maland16/bus-departure-board/README.md

# GPMetro Bus Stop Departure Board

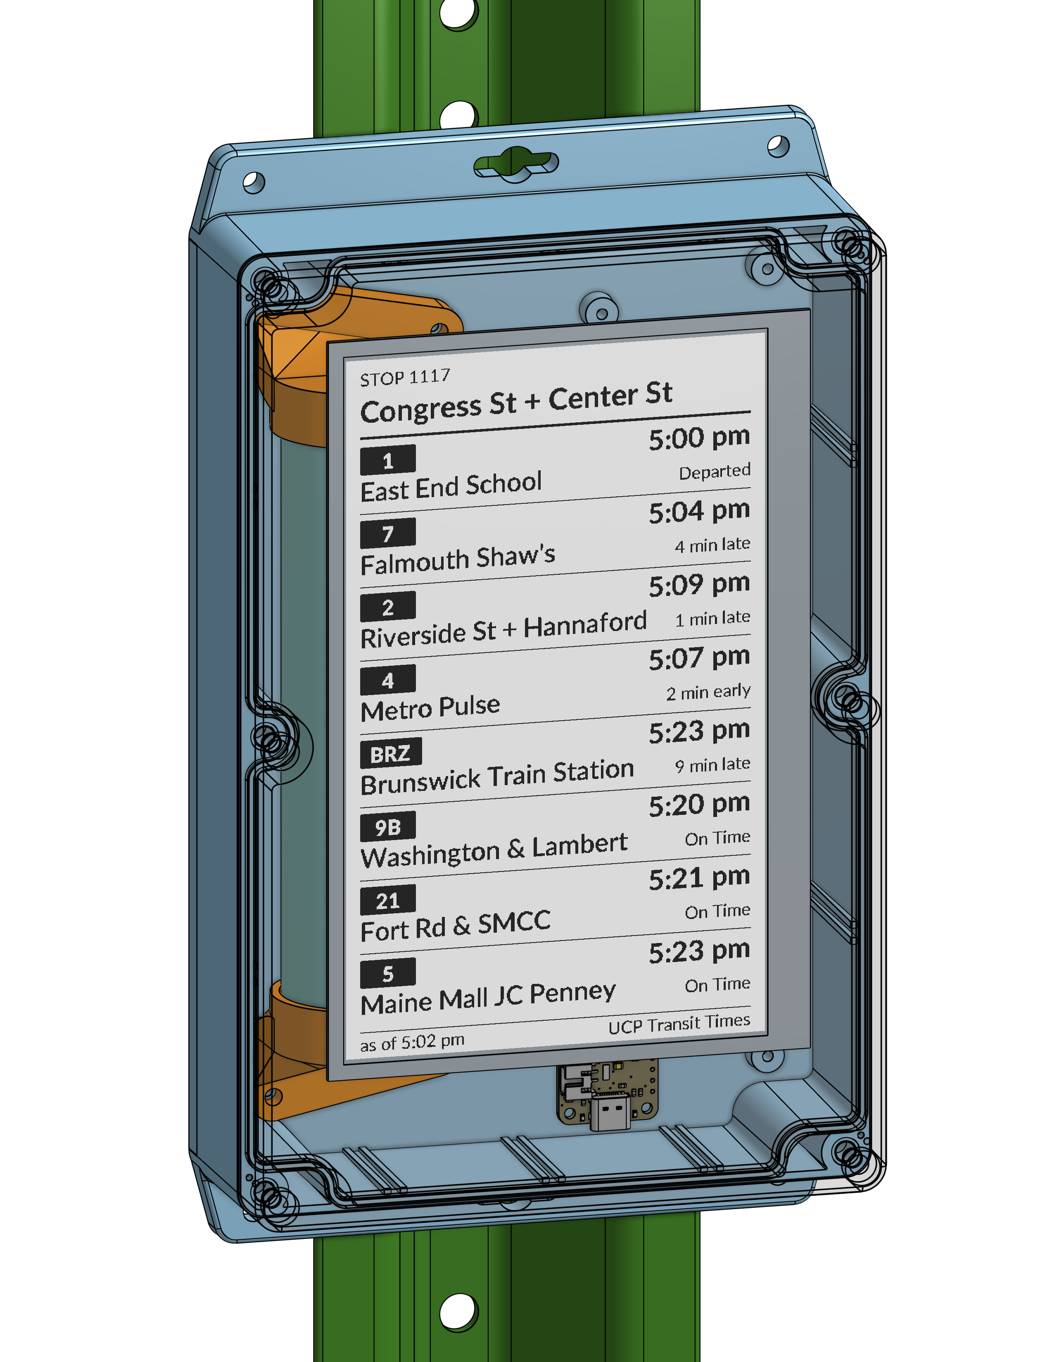
[picture p1: docs/Assembly 1.png]
Prototype departure board design

The goal of this project is to create a relatively low cost standalone live departure board for Portland Metro bus stops. This design uses an ESP32, e-ink display, and large LiFePo4 cell recharged via solar.

```mermaid
graph TD;

    A[GPMetro GTFS Feed] --> B["UCOP transit server parses GTFS and makes pretty image"];
    
    B -->|Bitmap image of recent & upcoming departures|C[ESP-32 Based display at bus stop];

    D["InfluxDB viewable via Grafana"] ---|"Telemetry Data (Batt/Solar voltage, temp, status, etc.)"|C;
```

## Electrical Topology

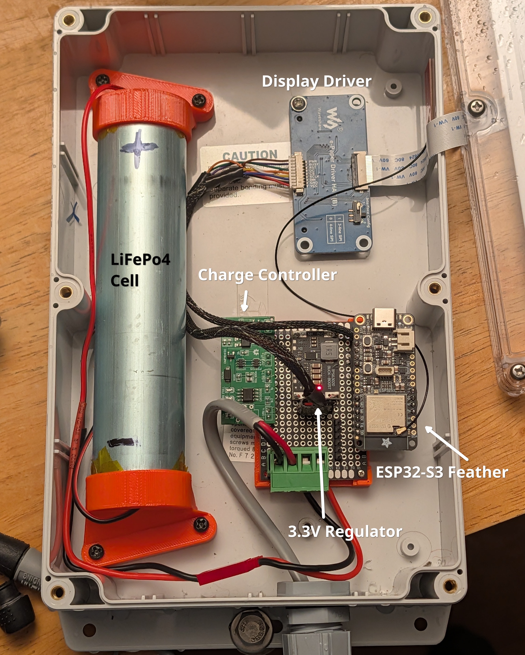
[picture p2: docs/V1-internals.jpg]
Internals


### [Read more here](docs/electricalTopology.md)

## Display

A Good Display GDEM075T41WT: a 7.5", 800x480 black/white e-paper panel rated for -25°C to 50°C. Specs, firmware notes and wiring are in [docs/display.md](docs/display.md).

## Physical Layer Options
- Wifi via ESP32 hardware [ Selected for version 1 ]
    - Advantages: Built into the ESP32 hardware, easy to setup and well supported
    - Disadvantages: Wifi is not hugely reliable outdoors, and relying on random public networks as a part of infrastructure isn't great
- LoRa via external hardware
    - Advantages: LoRa has far better range and probably better reliability, and there's only one bridge to the internet instead of one on each ESP32. This solution might also be more scalable, though I'm not super familir with the scalability of LoRa used for this purpose
    - Disadvantages: Requires working around bandwith limitations (no photos sent to displays), and requires a gateway to bridge LoRa -> HTTPS. Also requires getting and using specialized LoRa hardware
- Cellular
    - Advantages: Reliability, range, throughput (can still do bitmaps). This is what the commercially available products use.
    - Disadvantages: Cost (hardware, subscription), power consumption.
- A secret fourth thing??

### Arduino/ESP32 Libraries
**GxEPD2** - E-Ink display driver  
**WifiClientSecure** - For HTTPS  
**ESP32Time**

### Improvements for rev 2:
- Use backplane bracket inside the waterproof case so servicing is easier
    - Attach display to backplane instead of the front of the case
    - Attach all other bits to the backplane so it can be swapped out easily if needed
- Cellular connectivity
- Use [powerfeather ESP32](https://powerfeather.dev/)
- OTA updates, versioning
