maland16/bus-departure-board/docs/bom.md

| Part | Description | Link |
| --- | --- | - |
| ESP-32 | Adafruit ESP32-S3 Feather 8MB with w.FL Antenna (for better wifi reception) | [Adafruit store](https://www.adafruit.com/product/5885) |
| E-ink display | Good Display GDEM075T41WT, 7.5" 800x480 black/white, wide temperature (-25°C to 50°C), UC8179. See [display.md](display.md) | [Good Display](https://www.good-display.com/product/700.html) |
| Antenna | Text |  |
| Charge controller | Text |  |
| Enclosure | Text |  |
| Battery | Text |  |
| Solar panel | Text |  |
