maland16/bus-departure-board/src/departure-board/display-driver.cpp

#include "display-driver.h"

#include "GxEPD2_display_selection_new_style.h"

#include <WiFiClientSecure.h>
#include <HTTPClient.h>
#include <ESP32Time.h>
#include <esp_rom_crc.h>

#include <Fonts/FreeMonoBold9pt7b.h>
#include <Fonts/FreeMonoBold12pt7b.h>
#include <Fonts/FreeSans18pt7b.h>
#include <Fonts/FreeSansBold24pt7b.h>
#include <Fonts/FreeSans12pt7b.h>

#include "src/third-party/QRCode/src/rm_qrcode.h"

#include "wifi-driver.h"
#include "rtc-driver.h"
#include "wake-stats.h"

#define BITMAP_SIGNATURE (0x4D42) // "BM" in hex
#define MAX_EXPECTED_HEADER_POSITION_BYTES (50)
#define FETCH_IMAGE_TIMEOUT_MS (20000)
#define FETCH_IMAGE_TIMEOUT_EXPIRED(X) (millis() - X > FETCH_IMAGE_TIMEOUT_MS)
#define HTTP_GET_RETRIES (3)

HTTPClient http;

// ---- Fixed target dimensions (native GxEPD2_750_T7 resolution) ----
static const uint16_t PANEL_WIDTH  = 800;
static const uint16_t PANEL_HEIGHT = 480;

static const size_t FRAMEBUFFER_ROW_BYTES = (PANEL_WIDTH + 7) / 8;                 // 100
static const size_t FRAMEBUFFER_SIZE      = FRAMEBUFFER_ROW_BYTES * PANEL_HEIGHT;  // 48000

// Worst case row size across supported bit depths (24bpp is the largest per row)
static const size_t MAX_BMP_ROW_BYTES = ((uint32_t)PANEL_WIDTH * 24 + 31) / 32 * 4; // 2400

// ---- Static buffers, reused across calls ----
static uint8_t framebuffer[FRAMEBUFFER_SIZE];
static uint8_t bmpRowBuf[MAX_BMP_ROW_BYTES];
static bool blackTable[256]; // palette-index -> "is this black?" lookup for 1/8bpp BMPs

// CRC32 of the image currently on the panel, saved across deep sleep so we can
// skip refreshing when the downloaded image hasn't changed. Cleared whenever
// something else is drawn over the live image.
RTC_DATA_ATTR static uint32_t lastFramebufferCrc = 0;
RTC_DATA_ATTR static bool lastFramebufferCrcValid = false;

void initDisplayDriver()
{
    display.init(115200, true, 2, false); // Initialize display

    // don't keep the TCP/TLS connection alive between calls - a reused
    // connection that's gone stale (idle timeout, NAT/firewall drop) can
    // hang indefinitely on write with no error and no timeout, since that
    // happens below the level http.setTimeout() covers
    http.setReuse(false);
    http.setFollowRedirects(HTTPC_STRICT_FOLLOW_REDIRECTS); // in case the file is served via a CDN/redirect
    http.setTimeout(8000);
    Serial.println("Display initialized");
}

// ---- Blocking read of exactly `len` bytes from any Stream, with a stall timeout ----
static bool readFully(Stream &s, uint8_t *dst, size_t len, uint32_t timeoutMs = 8000) {
  size_t got = 0;
  uint32_t lastProgress = millis();
  while (got < len) {
    int avail = s.available();
    if (avail > 0) {
      int n = s.readBytes(dst + got, len - got);
      if (n > 0) {
        got += n;
        lastProgress = millis();
        continue;
      }
    }
    if (millis() - lastProgress > timeoutMs) return false; // stalled
    delay(1);
  }
  return true;
}

// ---- Skip `count` bytes forward in the stream ----
static bool skipBytes(Stream &s, uint32_t count) {
  uint8_t buf[32];
  while (count > 0) {
    uint32_t chunk = count > sizeof(buf) ? sizeof(buf) : count;
    if (!readFully(s, buf, chunk)) return false;
    count -= chunk;
  }
  return true;
}

static void drawCentered(const char *s, int cx, int baselineY) {
  int16_t x1, y1;
  uint16_t w, h;
  display.getTextBounds(s, 0, 0, &x1, &y1, &w, &h);
  display.setCursor(cx - w / 2 - x1, baselineY);
  display.print(s);
}

void showUnavailableImage(const char *url, const char *reason) {
  const uint8_t VERSION = 4;
  const int SCALE = 10;
  static uint8_t qrBuf[200];
  QRCode qr;
  qrcode_initText(&qr, qrBuf, VERSION, ECC_MEDIUM, url);

  display.setRotation(3); // portrait upside down on the 800x480 panel
  display.setFullWindow();

  const int panelW = display.width();
  const int qrPx = qr.size * SCALE;
  const int qrX = (panelW - qrPx) / 2;
  const int qrY = 24;
  const int textCx = panelW / 2;
  const int textStartY = qrY + qrPx + 72;

  const uint32_t refreshStartMs = millis();
  display.firstPage();
  do {
    display.fillScreen(GxEPD_WHITE);

    for (int y = 0; y < qr.size; y++) {
      for (int x = 0; x < qr.size; x++) {
        if (qrcode_getModule(&qr, x, y)) {
          display.fillRect(qrX + x * SCALE, qrY + y * SCALE, SCALE, SCALE, GxEPD_BLACK);
        }
      }
    }

    display.setTextColor(GxEPD_BLACK);
    display.setFont(&FreeSansBold24pt7b);
    drawCentered("Live tracking", textCx, textStartY);
    drawCentered("unavailable", textCx, textStartY + 58);
    display.setFont(&FreeSans12pt7b);
    drawCentered(reason, textCx, textStartY + 102);
    drawCentered("Scan for bus tracking info", textCx, textStartY + 136);
  } while (display.nextPage());
  wakeStats.refreshMs = millis() - refreshStartMs;

  display.hibernate();

  // The live image is no longer on the panel, so the next one must be drawn
  lastFramebufferCrcValid = false;
}

// Download the BMP at `url` and convert it into `framebuffer`. On failure,
// sets wakeStats.displayResult to BAD_IMAGE if the server sent something we
// can't use; otherwise the caller's DOWNLOAD_FAILED stands.
static bool downloadBmpToFramebuffer(const char *url) {
  client.setInsecure();

  if (display.width() != PANEL_WIDTH || display.height() != PANEL_HEIGHT) {
    Serial.printf("Display reports %dx%d, expected native %ux%u - check setRotation(0)\n",
                  display.width(), display.height(), PANEL_WIDTH, PANEL_HEIGHT);
    wakeStats.displayResult = DISPLAY_RESULT_BAD_IMAGE;
    return false;
  }

  if (!http.begin(client, url)) {
    Serial.println("http.begin() failed - malformed URL?");
    return false;
  } else {
    Serial.printf("http.begin() succeeded: %s\n", url);
  }

  Serial.printf("free: %u, largest block: %u\n",
  heap_caps_get_free_size(MALLOC_CAP_INTERNAL),
  heap_caps_get_largest_free_block(MALLOC_CAP_INTERNAL));

  int httpCode = http.GET();
  wakeStats.httpCode = httpCode;
  if (httpCode != HTTP_CODE_OK) {
    Serial.printf("HTTP GET failed: %d (%s)\n", httpCode, http.errorToString(httpCode).c_str());
    http.end();
    return false;
  } else {
    Serial.printf("HTTP GET succeeded: %d (%s)\n", httpCode, http.errorToString(httpCode).c_str());
  }

  WiFiClient *stream = http.getStreamPtr();
  if (!stream) {
    Serial.println("No response stream available");
    http.end();
    return false;
  } else {
    Serial.println("Response stream available");
  }

  // ---- BMP file header (14 bytes) ----
  uint8_t fileHeader[14];
  if (!readFully(*stream, fileHeader, sizeof(fileHeader))) {
    Serial.println("Failed to read BMP file header");
    http.end();
    return false;
  }
  if (fileHeader[0] != 'B' || fileHeader[1] != 'M') {
    Serial.println("Not a BMP file (missing 'BM' signature)");
    wakeStats.displayResult = DISPLAY_RESULT_BAD_IMAGE;
    http.end();
    return false;
  }
  uint32_t dataOffset = fileHeader[10] | (fileHeader[11] << 8) | (fileHeader[12] << 16) | ((uint32_t)fileHeader[13] << 24);

  // ---- DIB header (assume standard 40-byte BITMAPINFOHEADER) ----
  uint8_t dib[40];
  if (!readFully(*stream, dib, sizeof(dib))) {
    Serial.println("Failed to read DIB header");
    http.end();
    return false;
  }
  uint32_t dibSize      = dib[0]  | (dib[1]  << 8) | (dib[2]  << 16) | ((uint32_t)dib[3]  << 24);
  int32_t  bmpWidth     = (int32_t)(dib[4]  | (dib[5]  << 8) | (dib[6]  << 16) | ((uint32_t)dib[7]  << 24));
  int32_t  bmpHeightRaw = (int32_t)(dib[8]  | (dib[9]  << 8) | (dib[10] << 16) | ((uint32_t)dib[11] << 24));
  uint16_t bpp          = dib[14] | (dib[15] << 8);
  uint32_t compression  = dib[16] | (dib[17] << 8) | (dib[18] << 16) | ((uint32_t)dib[19] << 24);
  uint32_t colorsUsed   = dib[32] | (dib[33] << 8) | (dib[34] << 16) | ((uint32_t)dib[35] << 24);

  bool topDown = bmpHeightRaw < 0;
  uint32_t bmpHeight = topDown ? (uint32_t)(-bmpHeightRaw) : (uint32_t)bmpHeightRaw;

  Serial.printf("BMP %ldx%lu, %u bpp, compression=%lu, colorsUsed=%lu, topDown=%d\n",
                (long)bmpWidth, (unsigned long)bmpHeight, bpp,
                (unsigned long)compression, (unsigned long)colorsUsed, topDown);

  if (compression != 0) {
    Serial.println("Only uncompressed (BI_RGB) BMPs are supported");
    wakeStats.displayResult = DISPLAY_RESULT_BAD_IMAGE;
    http.end();
    return false;
  }
  if (bpp != 1 && bpp != 8 && bpp != 24) {
    Serial.printf("Unsupported bit depth: %u (only 1, 8, or 24 bpp supported)\n", bpp);
    wakeStats.displayResult = DISPLAY_RESULT_BAD_IMAGE;
    http.end();
    return false;
  }
  if ((uint32_t)bmpWidth != PANEL_WIDTH || bmpHeight != PANEL_HEIGHT) {
    Serial.printf("BMP size (%ldx%lu) does not match expected %ux%u - aborting\n",
                  (long)bmpWidth, (unsigned long)bmpHeight, PANEL_WIDTH, PANEL_HEIGHT);
    wakeStats.displayResult = DISPLAY_RESULT_BAD_IMAGE;
    http.end();
    return false;
  }

  // Skip any extra DIB header bytes (e.g. a V4/V5 header instead of the plain 40-byte one)
  if (dibSize > sizeof(dib)) {
    if (!skipBytes(*stream, dibSize - sizeof(dib))) { http.end(); return false; }
  }

  // ---- For 1/8 bpp, read the color palette so we know which index is "black" ----
  uint32_t paletteBytes = 0;
  if (bpp <= 8) {
    uint32_t numColors = colorsUsed != 0 ? colorsUsed : (1u << bpp);
    if (numColors > 256) numColors = 256;
    paletteBytes = numColors * 4;

    uint8_t palette[1024]; // 256 entries * 4 bytes max - small, fine on the stack
    if (!readFully(*stream, palette, paletteBytes)) {
      Serial.println("Failed to read color palette");
      http.end();
      return false;
    }
    for (uint32_t i = 0; i < numColors; i++) {
      uint8_t b = palette[i * 4 + 0];
      uint8_t g = palette[i * 4 + 1];
      uint8_t r = palette[i * 4 + 2];
      uint16_t gray = (r * 299 + g * 587 + b * 114) / 1000;
      blackTable[i] = (gray <= 128);
    }
  }

  // dataOffset is authoritative - skip forward if there's any gap left (rare)
  uint32_t consumedSoFar = 14 + dibSize + paletteBytes;
  if (dataOffset > consumedSoFar) {
    if (!skipBytes(*stream, dataOffset - consumedSoFar)) { http.end(); return false; }
  }

  // General BMP row-padding formula, works for 1/8/24 bpp alike
  const size_t rowBytesIn = (((uint32_t)PANEL_WIDTH * bpp + 31) / 32) * 4;
  if (rowBytesIn > sizeof(bmpRowBuf)) {
    // Can't happen with PANEL_WIDTH=800 and bpp in {1,8,24}, but guard anyway
    // since bmpRowBuf is a fixed-size static buffer.
    Serial.println("BMP row too large for static row buffer");
    wakeStats.displayResult = DISPLAY_RESULT_BAD_IMAGE;
    http.end();
    return false;
  }

  memset(framebuffer, 0xFF, FRAMEBUFFER_SIZE); // start all-white; we clear bits for black pixels

  const uint8_t threshold = 128; // used only for the 24bpp path; tune if needed

  bool ok = true;

  Serial.print("Downloading BMP");
  for (uint32_t r = 0; r < PANEL_HEIGHT; r++) {
    if(r % 10 == 0) { Serial.print("."); }

    if (!readFully(*stream, bmpRowBuf, rowBytesIn)) {
      Serial.printf("Failed reading BMP row %lu\n", (unsigned long)r);
      ok = false;
      break;
    }

    // BMP rows are bottom-to-top by default; map into the correct output row
    uint32_t outRow = topDown ? r : (PANEL_HEIGHT - 1 - r);
    uint8_t *destRow = framebuffer + outRow * FRAMEBUFFER_ROW_BYTES;
    
    if(r % 10 == 0) { Serial.print("`"); }

    for (uint16_t x = 0; x < PANEL_WIDTH; x++) {
      bool isBlack;

      if (bpp == 24) {
        uint8_t b  = bmpRowBuf[x * 3 + 0];
        uint8_t g  = bmpRowBuf[x * 3 + 1];
        uint8_t rr = bmpRowBuf[x * 3 + 2];
        uint16_t gray = (rr * 299 + g * 587 + b * 114) / 1000;
        isBlack = (gray <= threshold);
      } else if (bpp == 8) {
        uint8_t index = bmpRowBuf[x];
        isBlack = blackTable[index];
      } else { // bpp == 1
        uint8_t byteVal = bmpRowBuf[x / 8];
        uint8_t index = (byteVal >> (7 - (x % 8))) & 0x1;
        isBlack = blackTable[index];
      }

      if (isBlack) {
        destRow[x / 8] &= ~(0x80 >> (x % 8)); // clear the bit for black
      }
      // else: leave bit set (white) - buffer was pre-filled with 0xFF
    }
  }
  Serial.println(" download complete, closing HTTP connection");

  http.end();

  return ok;
}

bool drawBmpFromUrl(const char *url) {
  Serial.printf("stack high water mark (beginning of display loop): %u bytes free\n", uxTaskGetStackHighWaterMark(NULL));

  wakeStats.displayResult = DISPLAY_RESULT_DOWNLOAD_FAILED;
  const uint32_t downloadStartMs = millis();
  const bool downloaded = downloadBmpToFramebuffer(url);
  wakeStats.downloadMs = millis() - downloadStartMs;

  if (!downloaded) {
    return false;
  }

  // E-ink holds its image without power, so if nothing changed skip the
  // refresh and save the power (and panel wear)
  const uint32_t framebufferCrc = esp_rom_crc32_le(0, framebuffer, FRAMEBUFFER_SIZE);
  if (lastFramebufferCrcValid && framebufferCrc == lastFramebufferCrc) {
    Serial.println("Image unchanged since last refresh; skipping display update");
    wakeStats.displayResult = DISPLAY_RESULT_UNCHANGED;
    display.hibernate();
    return true;
  }

  const uint32_t refreshStartMs = millis();
  display.writeImage(framebuffer, 0, 0, PANEL_WIDTH, PANEL_HEIGHT); // flip to writeImage(..., true) if colors look inverted

  display.refresh();
  wakeStats.refreshMs = millis() - refreshStartMs;
  wakeStats.displayResult = DISPLAY_RESULT_REFRESHED;

  lastFramebufferCrc = framebufferCrc;
  lastFramebufferCrcValid = true;

  Serial.println("Image drawn");

  display.hibernate();

  Serial.printf("stack high water mark (end of display loop): %u bytes free\n", uxTaskGetStackHighWaterMark(NULL));
  return true;
}
