maland16/bus-departure-board/src/departure-board/debug-print.h

#ifndef DEBUG_PRINT_H
#define DEBUG_PRINT_H

#define DEBUG_MODE

#ifdef DEBUG_MODE
#define DEBUG_PRINTLN(X) \
    Serial.print("[DEBUG "); \
    Serial.print(__func__); \
    Serial.print("():"); \
    Serial.print(__LINE__); \
    Serial.print("] "); \
    Serial.println(X);
#else
#define DEBUG_PRINTLN(...)
#endif

#define ERROR_PRINTLN(X)  \
    Serial.print("[ERROR "); \
    Serial.print(__func__); \
    Serial.print("():"); \
    Serial.print(__LINE__); \
    Serial.print("] "); \
    Serial.println(X);

#endif // DEBUG_PRINT_H
