maland16/bus-departure-board/(commit log)

2026-01-17 Added python script for grabbing departure board from UCOP website
2026-01-29 organization & the beginnings of a state machine! doesn't build tho :(
    [debug-print.h, departure-board.ino, display-driver.cpp, display-driver.h, rtc-driver.cpp, rtc-driver.h, wifi-driver.cpp]
2026-09-26 first pass cycle with deep sleep & some basic battery code
2026-10-02 cleanup unused code in display-driver
2026-10-03 Fixed .gitignore, display driver cleanup
    [deep-sleep-driver.h, display-driver.cpp, display-driver.h]
2026-10-04 Updated ADC code with new resistor dividers
2026-10-05 updated battery driver with 2 ADC channels for solar and batt
2026-10-06 Removed nvm driver, used rtc ram for storing over deep sleep. Updated display to only show unavailable if stale for >30 min
2026-10-20 Enable low battery detection & power saving measures
2026-10-22 Enhance battery and wifi management for improved reliability
    - Cache solar and battery voltage readings to avoid ADC2 issues during WiFi operation.
    - Update initBatteryDriver() to sample voltages before WiFi initialization.
    - Implement backoff strategy for WiFi reconnection attempts to save battery.
    - Add telemetry reporting for consecutive WiFi failures.
    - Improve handling of NTP synchronization based on WiFi connectivity.
2026-10-22 Remove debug print macros and replace with direct Serial prints for clarity
2026-10-22 Update battery cutoff voltage, enhance display driver with CRC checks, and add sketch configuration for ESP32-S3
